OpenSourceSDRLab/FMC-AD9371/images/FMC-AD9371-angle-2.jpg

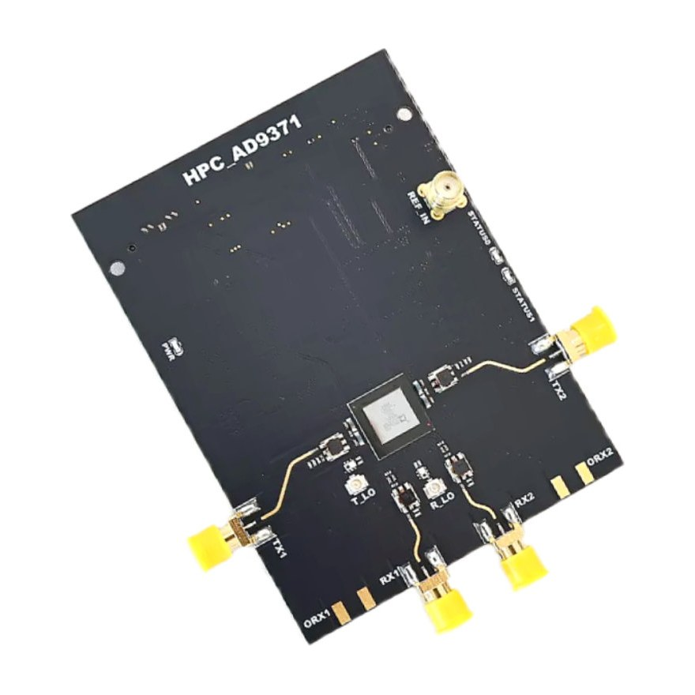
images/FMC-AD9371-angle-2.jpg
