OpenSourceSDRLab/FMC-AD9371/images/FMC-AD9371-bottom.jpg

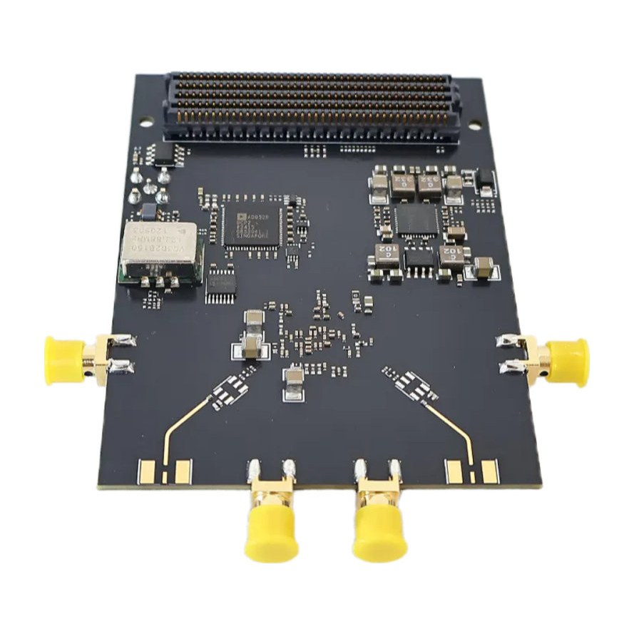
images/FMC-AD9371-bottom.jpg
