OpenSourceSDRLab/FMC-AD9371/images/FMC-AD9371-top-bottom.jpg

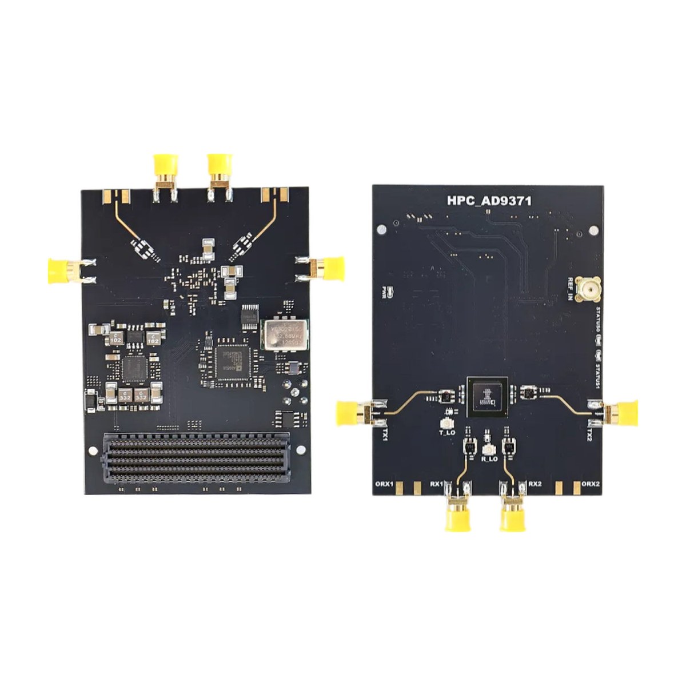
images/FMC-AD9371-top-bottom.jpg
