OpenSourceSDRLab/FMC-AD9371/images/FMC-AD9371-top.jpg

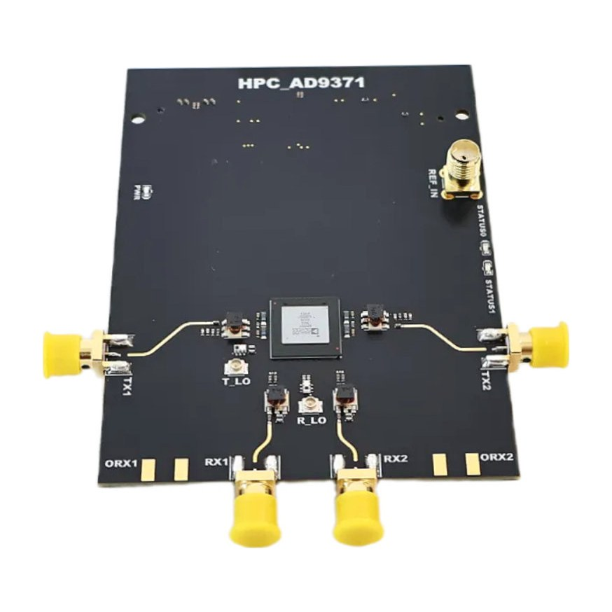
images/FMC-AD9371-top.jpg
